ModelRocketryAvionics/RF-Board/RF Project/Tx-Rx.kicad_pcb

## KiCad design RF Project/Tx-Rx.kicad_pcb (2018-07-21)

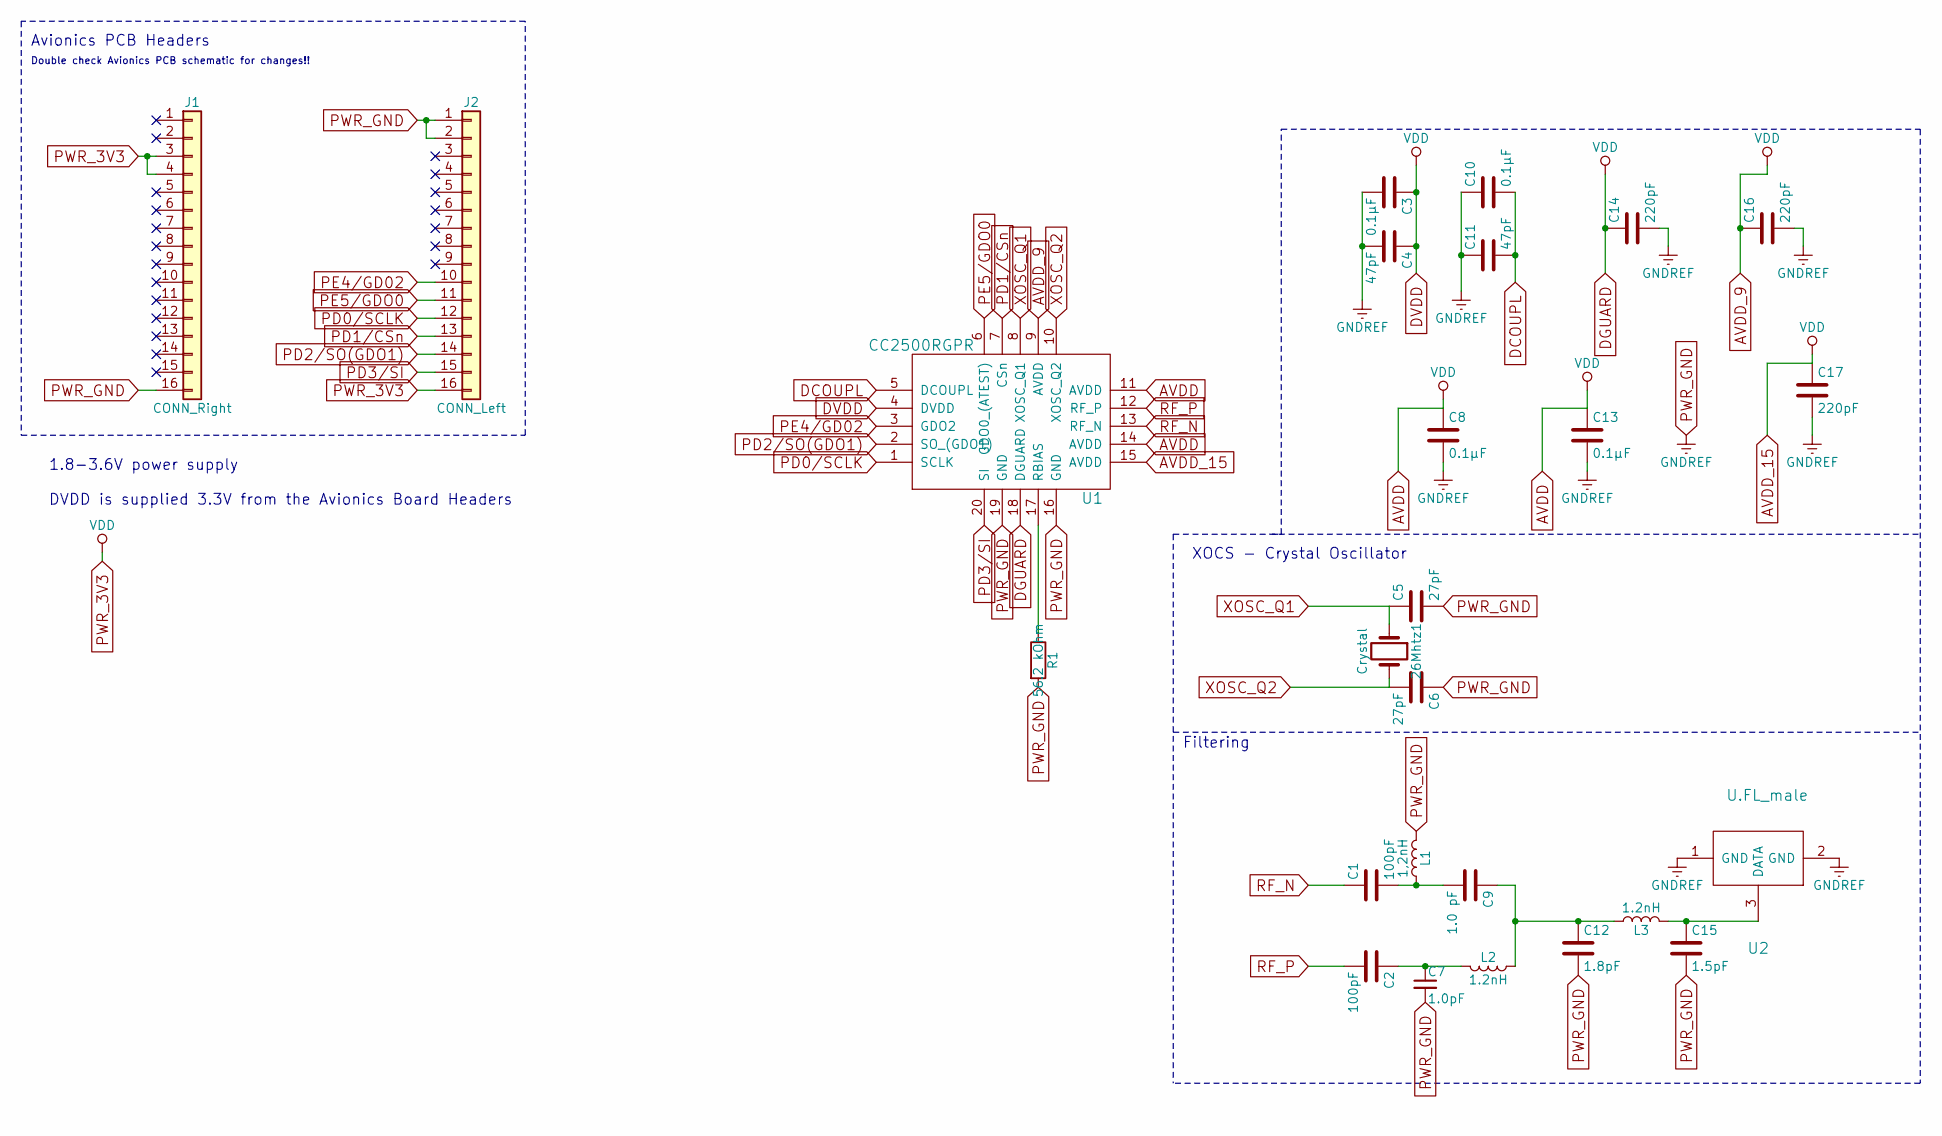
[picture p1: schematic Tx-Rx.sch, Model Rocket Transciever Design]

Parts:
26Mhtz1: Crystal; Crystal_SMD_Abracon_ABM3B-4pin_5.0x3.2mm
C1, C2: 100pF; C_0402
C3, C8, C10, C13: 0.1μF; C_0402
C4, C11: 47pF; C_0402
C5, C6: 27pF; C_0402
C7: 1.0pF; C_0402
C9: 1.0 pF; C_0402
C12: 1.8pF; C_0402
C14, C16, C17: 220pF; C_0402
C15: 1.5pF; C_0402
J1: CONN_Right; Pin_Header_Straight_1x16_Pitch2.54mm
J2: CONN_Left; Pin_Header_Straight_1x16_Pitch2.54mm
L1: 1,2nH; L_0402
L2, L3: 1.2nH; L_0402
R1: 56.2 kOhm; R_0402; Digikey Part No. CR0402-FX-5622GLFCT-ND
U1: CC2500RGPR; CC2500
U2: U.FL_male; u.fl_male

Connections:
AVDD: C3.1, C4.1, C8.1, C13.1, C14.1, C16.1, C17.1, J1.3, J1.4, J2.16, U1.4 (DVDD), U1.9 (AVDD), U1.11 (AVDD), U1.14 (AVDD), U1.15 (AVDD), U1.18 (DGUARD)
DCOUPL: C10.2, C11.2, U1.5 (DCOUPL)
unnamed: C1.2, C9.2, L1.1
unnamed: C2.1, C7.1, L2.2
unnamed: C9.1, C12.1, L2.1, L3.1
unnamed: C15.1, L3.2, U2.3 (DATA)
unnamed: R1.1, U1.17 (RBIAS)
PD0/SCLK: J2.12, U1.1 (SCLK)
PD1/CSn: J2.13, U1.7 (CSn)
PD2/SO(GDO1): J2.14, U1.2 (SO_(GDO1))
PD3/SI: J2.15, U1.20 (SI)
PE4/GD02: J2.10, U1.3 (GDO2)
PE5/GDO0: J2.11, U1.6 (GDO0_(ATEST))
PWR_GND: C3.2, C4.2, C5.2, C6.1, C7.2, C8.2, C10.1, C11.1, C12.2, C13.2, C14.2, C15.2, C16.2, C17.2, J1.16, J2.1, J2.2, L1.2, R1.2, U1.16 (GND), U1.19 (GND), U2.1 (GND), U2.2 (GND)
RF_N: C1.1, U1.13 (RF_N)
RF_P: C2.2, U1.12 (RF_P)
XOSC_Q1: 26Mhtz1.1, C5.1, U1.8 (XOSC_Q1)
XOSC_Q2: 26Mhtz1.2, C6.2, U1.10 (XOSC_Q2)

Notes on the sheet:
1.8-3.6V power supply DVDD is supplied 3.3V from the Avionics Board Headers
XOCS - Crystal Oscillator
Filtering
Avionics PCB Headers
Double check Avionics PCB schematic for changes!!

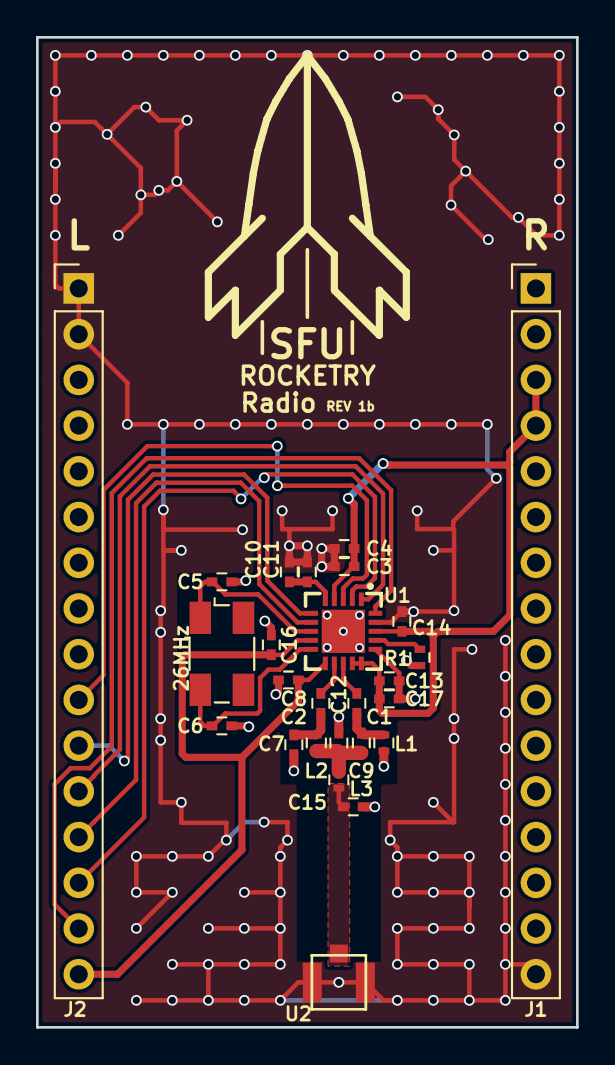
[picture p2: board Tx-Rx.kicad_pcb from above]

Board: 2 copper layers, 30.0 x 55.0 mm, 26 parts (0 on the bottom side), 18 nets.
