ModelRocketryAvionics/RF-Board/(commit log)

2018-07-17 Added Avionics Headers to schematic, fixed library link issues (hopefully) and started working on Layout
    [Tx-Rx.kicad_pcb, Tx-Rx.sch]
2018-07-17 Fixed CC2500 footprint (missing gnd pad) finished layout, needs CDR
    [Tx-Rx.kicad_pcb]
2018-07-17 fixed Crystal SilkScreen label
    [Tx-Rx.kicad_pcb]
2018-07-17 Resurrected kicad_pcb from the grave
    [Tx-Rx.kicad_pcb]
2018-07-17 Moved components so that they weren't inside the CC2500 (woops), also changed the resistor to 0402 instead of 0201 since those aren't in stock QQ
    [Tx-Rx.kicad_pcb]
2018-07-17 Fixed my poor attempt to move stuff :(
    [Tx-Rx.kicad_pcb]
2018-07-17 Labelled headers Left/Right since someone who isn't me totally messed up and put the right header on the left and the left header on the right then did the entire layout and doesn't want to redo it (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
    [Tx-Rx.kicad_pcb]
2018-07-17 shifted the headers down by 3.77mm since Harrisons board is centered at 102.5mm not 100mm and I thought 15/2 was 8 (woops). Still haven't swapped left with right, that would take too long :P
    [Tx-Rx.kicad_pcb]
2018-07-17 Fixed stuff and hopefully non gitbash people will actually be able to download and see this..
    [Tx-Rx.kicad_pcb]
2018-07-17 Made things more pretty
    [Tx-Rx.kicad_pcb]
2018-07-17 finished fixing T's stuff
    [Tx-Rx.kicad_pcb]
2018-07-17 finished fixing T's stuff2
    [Tx-Rx.kicad_pcb]
2018-07-18 Attempted to increase trace width to reduce impedance mismatch (could only achieve ~1mm or 88.3 Ohm vs the desired 50 Ohm), cleaned up some via placements/fills/silkscreen things
    [Tx-Rx.kicad_pcb]
2018-07-18 Exported GRBL files and final .zip
    [Tx-Rx-B.Cu.gbl, Tx-Rx-B.Mask.gbs, Tx-Rx-B.Paste.gbp, Tx-Rx-B.SilkS.gbo, Tx-Rx-Edge.Cuts.gm1, Tx-Rx-F.Cu.gtl, Tx-Rx-F.Mask.gts, Tx-Rx-F.Paste.gtp]
2018-07-20 Fixed disconnection of a via on L1 of the RF output with the GND plane
    [Tx-Rx.kicad_pcb]
2018-07-21 Layout Revision 1b complete, notable additions: 1) Moved headers onto correct side, added pads for a RF Shield, main feed line to UFL connector is impedance matched to ~50ohm, incrememted the revisio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
    [Tx-Rx.kicad_pcb]
2018-07-21 Added gerbers to Output/
    [Tx-Rx-B.Cu.gbl, Tx-Rx-B.Mask.gbs, Tx-Rx-B.Paste.gbp, Tx-Rx-B.SilkS.gbo, Tx-Rx-Edge.Cuts.gm1, Tx-Rx-F.Cu.gtl, Tx-Rx-F.Mask.gts, Tx-Rx-F.Paste.gtp]
