ModelRocketryAvionics/RF-Board/(notices)

Notices in the files:
RF Project/RF Project/Tx-Rx.sch:
creativecommons.org/liscences/by/4.0
Liscence CC BY 4.0
